pbnather/iot-project/Schematic V1.0.png

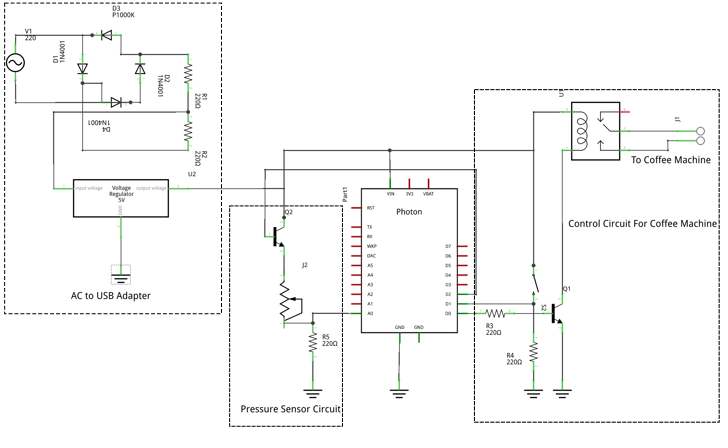
Schematic V1.0.png
